xiongjiazi/My-STC32-Troubleshooting-Guide/Schematic diagram and PCB/key circuit.png

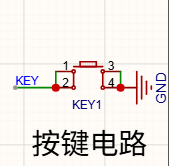
Schematic diagram and PCB/key circuit.png
