xiongjiazi/My-STC32-Troubleshooting-Guide/Schematic diagram and PCB/LDO Vin.jpg

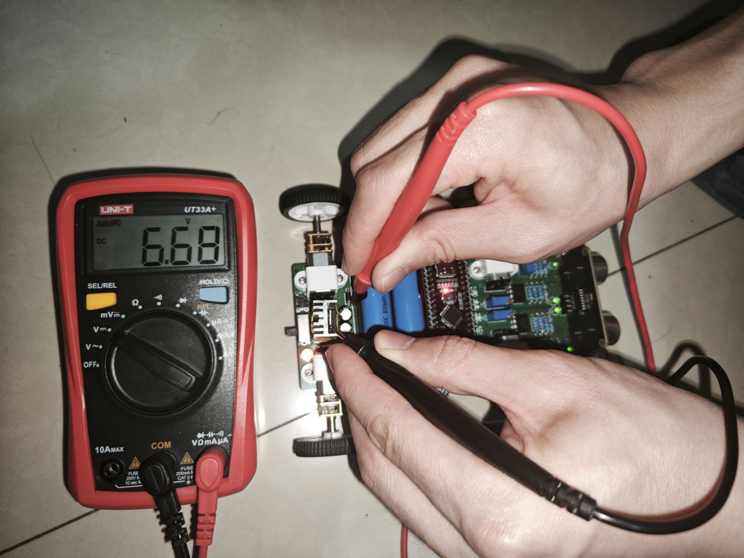
Schematic diagram and PCB/LDO Vin.jpg
