xiongjiazi/My-STC32-Troubleshooting-Guide/Schematic diagram and PCB/schematic_full.png

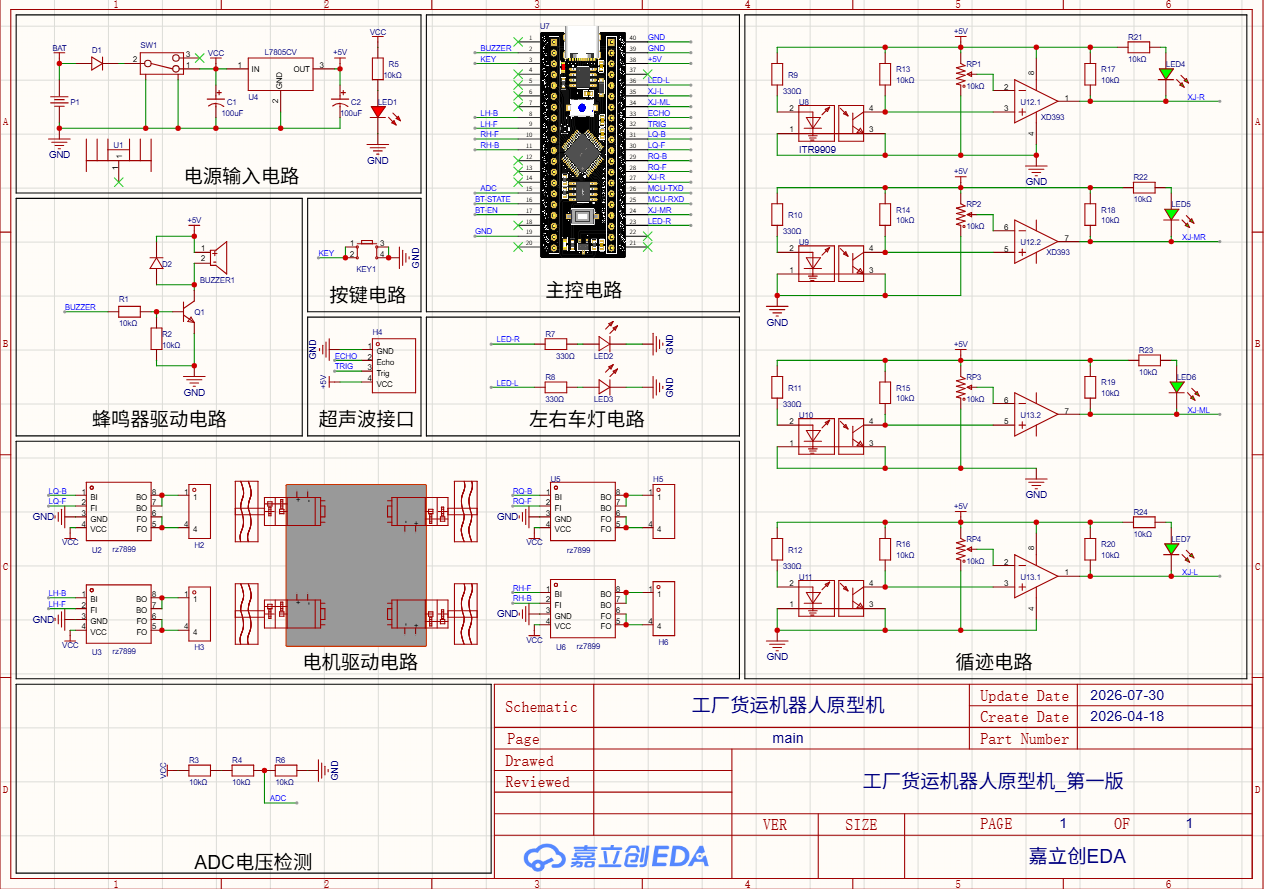
Schematic diagram and PCB/schematic_full.png
