xiongjiazi/My-STC32-Troubleshooting-Guide/BOM.xls

序号 | 原始需求 | 原始需求 | 原始需求 | 原始需求 | 匹配结果 | 嘉立创推荐用料 | 嘉立创推荐用料 | 嘉立创推荐用料 | 嘉立创推荐用料 | 嘉立创推荐用料 | 嘉立创推荐用料 | 预报价 | 预报价 | 预报价 | 预报价
序号 | 型号 | 封装 | 单套用量 | 位号 | 匹配结果 | 商品名称 | 型号 | 品牌 | 封装 | 类目 | 配单C编号 | 渠道来源 | 需求用量 | 单价 | 小计
1 | HDR-M_2.54_1x4P | HDR-TH_4P-P2.54-V-M | 4 | H2,H3,H5,H6 | 系统匹配 | 1x4P 间距:2.54mm 方针 直插【排针】 | PZ254V-11-04P | XFCN(兴飞) | HDR-TH_4P-P2.54-V-M | 排针 | C492403 | 现货 | 9 | 0.156 | 1.4
2 | 散热片15.5*10.5*24带针 | HEATSINK-TH_L15.5-W10.5-XSD1226-005 | 1 | U1 | 系统匹配 | XSD(鑫顺达)to-220二极管铝型材散热片 15.5*10.5*24 本色带针大功率电子散热器（可定制）【散热】 | 15.5*10.5*24 | XSD(鑫顺达) | HEATSINK-TH_L15.5-W10.5-XSD1226-005 | 散热片 | C108928 | 现货 | 3 | 0.509 | 1.53
3 | S8050 | TO-92-3_L5.1-W4.1-P1.27-L | 1 | Q1 | 系统匹配 | S8050 | S8050 | JSMSEMI(杰盛微) | TO-92-3_L4.5-W3.5-P1.27-L | 三极管(BJT) | C2931492 | 现货 | 5 | 0.0731 | 0.37
4 | SK-12E12-G5 | SW-TH_SK-12E12-G5 | 1 | SW1 | 系统匹配 | 卧插双档 滑动开关 【拨动】 | SK-12E12-G5 | 韩国韩荣 | SW-TH_SK-12E12-G5 | 滑动开关 | C136720 | 现货 | 2 | 0.65 | 1.3
6 | Key_TH_6x6x4.5 | KEY-TH_4P-L6.0-W6.0-P3.90-LS6.5 | 1 | KEY1 | 系统匹配 | 6*6*4.5mm 直插 轻触开关 【插件】 | TS-1095PD-A2B3-D2 | Yuandi(元迪) | KEY-TH_4P-L6.0-W6.0-P3.90-LS6.5 | 轻触开关 | C2834896 | 现货 | 3 | 0.313 | 0.94
7 | 330Ω | RES-TH_BD2.3-L6.5-P10.50-D0.5 | 6 | R7,R8,R9,R10,R11,R12 | 系统匹配 | 金属膜电阻 330Ω ±1% 250mW 【插件】 | MF1/4W-330Ω±1%T52 | 华星机电 | RES-TH_BD2.3-L6.5-P10.50-D0.5 | 插件电阻 | C713986 | 现货 | 17 | 0.0617 | 1.05
8 | 10kΩ | RES-TH_BD2.4-L6.3-P10.30-D0.6 | 18 | R1,R2,R3,R4,R5,R6,R13,R14,R15,R16,R17,R18,R19,R20,R21,R22,R23,R24 | 系统匹配 | 10kΩ ±1% 250mW 金属膜电阻 【插件】 | RN1/4W10KFT/BA1 | Tyohm(幸亚电阻) | RES-TH_BD2.4-L6.3-P10.30-D0.6 | 插件电阻 | C410695 | 现货 | 41 | 0.0811 | 3.33
9 | L7805CV | TO-220-3_L10.0-W4.5-P2.54-L | 1 | U4 | 系统匹配 | 5V 1.5A 35V【线性】 | L7805CV | ST(意法半导体) | TO-220-3_L10.0-W4.5-P2.54-L | 线性稳压器(LDO) | C111887 | 现货 | 2 | 2.34 | 4.68
10 | XD393 | DIP-8_L9.7-W6.4-P2.54-LS7.6-BL | 2 | U12,U13 | 系统匹配 | 模拟比较器 【插件】 | XD393 | XINLUDA(信路达) | DIP-8_L9.7-W6.4-P2.54-LS7.6-BL | 比较器 | C561266 | 邮寄 | 4 | 0.517 | 2.64
11 | 1N4007 | DO-41_BD2.4-L4.7-P8.70-D0.9-RD | 2 | D1,D2 | 系统匹配 | 1N4007 | 1N4007 | LGE(鲁光) | DO-41_BD2.4-L4.7-P8.70-D0.9-RD | 通用二极管 | C402311 | 现货 | 9 | 0.139 | 1.25
12 | 100uF | CAP-TH_BD6.3-P2.50-D1.0-FD | 2 | C1,C2 | 系统匹配 | 100uF ±20% 35V 【引线】 | KM107M035E11RR0VH2FP0 | Chengx(承兴) | CAP-TH_BD6.3-P2.50-D1.0-FD | 直插铝电解电容 | C19504 | 邮寄 | 5 | 0.144 | 1.11
13 | SEA-0955Y-0527-16Ω-50P4.0 | BUZ-TH_BD9.2-P4.00-D0.6-FD | 1 | BUZZER1 | 系统匹配 | 无源电磁蜂鸣器【插件】 | SEA-0955Y-0527-16Ω-50P4.0 | S&S(海旭) | BUZ-TH_BD9.2-P4.00-D0.6-FD | 蜂鸣器 | C2693580 | 现货 | 2 | 1.0026 | 2.01
14 | LED_TH-G_3mm | LED-TH_BD3.0-P2.54-FD | 4 | LED4,LED5,LED6,LED7 | 系统匹配 | 普绿/黄绿 【发光】 | TJ-L3FYTGHKMCGLFLC7K-A5 | TOGIALED(统佳) | LED-TH_BD3.9-P2.54-FD | 发光二极管/LED | C330929 | 现货 | 13 | 0.211 | 2.74
15 | 10kΩ | RES-ADJ-TH_3P-L10.0-W10.0-P2.50-L | 4 | RP1,RP2,RP3,RP4 | 系统匹配 | 10kΩ ±10% 【可调】 | 3296W-1-103 | BOCHEN(博晨) | RES-ADJ-TH_3P-L10.0-W10.0-P2.50-L | 可调电阻/电位器 | C118954 | 现货 | 8 | 1.16 | 9.28
16 | ITR9909 | OPTO-TH_ITR9909 | 4 | U8,U9,U10,U11 | 未匹配 |  |  |  |  |  |  | 不贴 | 20 | 0.5 | 10
17 | LED_TH-R_3mm | LED-TH_BD3.0-P2.54-FD | 1 | LED1 | 未匹配 |  |  |  |  |  |  | 不贴 | 5 | 0.09 | 0.45
18 | TJ-L5FCMYGTDLSFLC6TW-A5 | LED-TH_BD5.8-P2.54-FD | 2 | LED2,LED3 | 未匹配 |  |  |  |  |  |  | 不贴 | 10 | 0.09 | 0.9
19 | 14500*2插针电池座 | 14500*2插针 | 1 | P1 | 未匹配 |  |  |  |  |  |  | 不贴 | 5 | 0.99 | 4.95
20 | 直流电机N20 | 直流电机N20_水平装配 | 4 | ASS_1,ASS_1,ASS_1,ASS_1 | 未匹配 |  |  |  |  |  |  | 不贴 | 20 | 19.46 | 63.88
21 | STC32G12K128核心板 | STC32G12K128核心板 | 1 | U7 | 未匹配 |  |  |  |  |  |  | 不贴 | 5 | 24.5 | 122.5
22 | HC-HR04 | HC-HR04 | 1 | H4 | 未匹配 |  |  |  |  |  |  | 不贴 | 5 | 3.82 | 19.1
23 | rz7899 | SOP-8_L4.9-W3.9-P1.27-LS6.0-BL | 4 | U2,U3,U5,U6 | 未匹配 |  |  |  |  |  |  | 不贴 | 20 | 0.96 | 19.2
