xiongjiazi/My-STC32-Troubleshooting-Guide/(list of files, cad)

Other CAD files:
红外循迹/Objects/main.obj
红外循迹/Objects/timer.obj
红外循迹/Objects/hw.obj
红外循迹/Objects/delay.obj
红外循迹/Objects/motor.obj
红外循迹/Objects/LED.obj
